TomCodesCode/EspressoMonitor/(commit log)

2026-03-25 SCT calibration logic upgrade. upgraded to TFT_eSPI touch screen. added NVS boot counter.
2026-03-30 sensor calibration + anti-flicker management
2026-03-31 SD configuration added. 3 wire mode temp sensor (upgrade from previous 2wire testing)
2026-04-13 continue. TODO: split some sensor logic to core0 (server) for fps boost?
2026-04-16 moving MAX31865 (PT100 temp sensor) to new GPIO pins (CS stays at D5)- SDI(12), SDO(13), CLK(16).
2026-04-17 new bus and 2 core architecture. but 3wire mode is not working. did it ever? maybe actually 2wire initiated?
    [CurrentManager.cpp, DisplayManager.cpp, EspressoMonitor.ino, SDManager.cpp, SDManager.h, SensorManager.cpp, SensorManager.h]
2026-04-19 MAX31865 board bricked. New undocumented factory defect found- pin 6 of MAX31865 has no trace. Until new parts arrive- test without temp sensor
2026-04-19 updated pin layout in txt file. stable. TODO: test again with new MAX31865!
2026-05-19 tested with new MAX31865: 3WIRE works. RREF resistor value updated. system stable. slight stutter to keep in mind for WARMUP screen. move on to UI work.
2026-06-03 1st optimization. SPI mutex, logs and charts stability.
    [BrewSession.h, CurrentManager.cpp, CurrentManager.h, DisplayManager.cpp, DisplayManager.h, EspressoMonitor.ino, SDManager.cpp, SDManager.h]
2026-06-09 Added graph viewing to server. fixed server displayed temps and real time logs
    [EspressoMonitor.ino, SDManager.cpp, SDManager.h, ServerManager.h]
2026-06-10 Dynamic variables instead of hardcoded. and more. see desc.
    * dynamic temp vars and Newton's equation update.
    * frames are dynamically capped to 30fps. optimized.
    * UI bug fixes.
    * Shot rating and upload to server label logic.
    * no more serial SCT current readings spam.
    * fixed crash on default melody state.
    * server stability.
    * TODO: screen dims every melody tone. need to find a 100uF capacitor to put on the buzzer's 3.3-GND.
    [CurrentManager.cpp, DisplayManager.cpp, DisplayManager.h, EspressoMonitor.ino, SDManager.cpp, SensorManager.cpp, SensorManager.h]
2026-06-11 fixed calibrated GH start temp cap issue where 40-50 didnt register
    [EspressoMonitor.ino]
2026-06-11 Solved longevity of NVS issue
    - tau calculation no longer would write multiple times per calibration and now would only update on exit from Settings screen.
    [EspressoMonitor.ino]
2026-06-14 SCT moved back to Core1 for stability. Buzzer moved from 3.3v to 5v VIN, stopping screen flicker.
    [CurrentManager.cpp, DisplayManager.cpp, DisplayManager.h, EspressoMonitor.ino, SensorManager.cpp, SensorManager.h, SoundManager.cpp]
2026-06-14 fixed issue where Ready screen timer and temp had bad responsiveness.
    [EspressoMonitor.ino]
2026-06-14 Server/SD update: no more csv to String in heap. stream each log directly to server from SD with 512B limit buffer.
    SPI mutex should no be free for the temp readings between log readings.
2026-06-14 Fix brew detection, ready screen, and log streaming
    - pump sensing back in loop() instead of the core 0 worker, so the wifi
    stack stops jittering the readings. lower touch threshold to 250.
    - restart the ready timer after a brew, and repaint on second ticks + temp
    toggle so it's not laggy.
    - only run the GH model in warmup; in ready just show the target. fixes the
    stuck-40 and the wave sitting too high. arc no longer resets after settings.
    - stream the log endpoints in 512b chunks instead of reading the whole file
    into a String (was fragmenting the heap and hanging at ~200 rows).
    - ntfy POST timeouts, overflow-safe wifi reconnect timer, atomic
    heatsoak/boiler-ready flags, spinbox m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
    [CurrentManager.cpp, DisplayManager.cpp, DisplayManager.h, EspressoMonitor.ino, version.h]
2026-06-15 added boiler sensor temp safety net and +/-25c jump guard
2026-06-15 adjusting brew current threshold from maxNoise + 20 to +30
2026-06-21 fixed bug in settings where changes were not saved in NVS properly
    [DisplayManager.cpp, EspressoMonitor.ino]
2026-09-17 restructure into monorepo; migrate v1 to platformio
    - move v1 (espresso monitor) sources under espresso-monitor/ as a platformio project
    - add scale/ (esp32-c3 + hx711 calibration node, two envs via SCALE_ID) and grinder-control/ (esp32-s3 esp-now skeleton)
    - add shared/esp_now_protocol.h so every node shares one esp-now packet layout
    - pin pioarduino arduino-esp32 3.x to match the arduino ide core; lvgl 9.5.0 with absolute lv_conf path
    - port tft_espi setup into build flags; drop stray platform includes; rename EspressoMonitor.ino to .cpp with forward decls
2026-09-17 scale: add weight readout mode (apply calibration factor, show grams + raw)
2026-09-23 grinder: phase-b display bring-up test (tft_espi gc9a01 on esp32-2424S012)
2026-10-04 main box: set core_debug_level=0 (silences buzzer noTone spam + note jitter)
2026-10-04 main box: log reset reason to SD on boot + kill stuck buzzer tone at startup
    [EspressoMonitor.cpp]
2026-10-04 server: add boot/crash log view; clear logs also wipes boot_reasons.csv
    [SDManager.cpp, ServerManager.h]
